olinxia/Olin_BlueStampPortfolio/ceres_data.h

// Generated from Horizons ephemeris data
#include <avr/pgmspace.h>

const uint16_t ceres_num_records = 1218;

const float ceres_ra_deg[] PROGMEM = {
  313.111208f,
  314.306208f,
  315.503042f,
  316.700958f,
  317.899417f,
  319.097958f,
  320.296167f,
  321.493667f,
  322.690042f,
  323.884875f,
  325.077667f,
  326.267833f,
  327.454875f,
  328.638458f,
  329.818250f,
  330.994042f,
  332.165625f,
  333.332792f,
  334.495292f,
  335.652833f,
  336.805000f,
  337.951417f,
  339.091750f,
  340.225833f,
  341.353458f,
  342.474542f,
  343.588917f,
  344.696417f,
  345.796792f,
  346.889708f,
  347.974833f,
  349.051750f,
  350.120167f,
  351.179958f,
  352.230875f,
  353.272750f,
  354.305375f,
  355.328375f,
  356.341417f,
  357.344000f,
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
};

const float ceres_dec_deg[] PROGMEM = {
  -24.848167f,
  -24.542139f,
  -24.229139f,
  -23.909389f,
  -23.583111f,
  -23.250528f,
  -22.911861f,
  -22.567306f,
  -22.217167f,
  -21.861694f,
  -21.501278f,
  -21.136250f,
  -20.767000f,
  -20.393861f,
  -20.017139f,
  -19.637139f,
  -19.254139f,
  -18.868500f,
  -18.480556f,
  -18.090722f,
  -17.699389f,
  -17.307083f,
  -16.914139f,
  -16.520944f,
  -16.127833f,
  -15.735167f,
  -15.343306f,
  -14.952611f,
  -14.563500f,
  -14.176444f,
  -13.791917f,
  -13.410389f,
  -13.032278f,
  -12.657917f,
  -12.287694f,
  -11.921972f,
  -11.561139f,
  -11.205639f,
  -10.855944f,
  -10.512583f,
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
};

const float ceres_dist_au[] PROGMEM = {
  3.798340f,
  3.818357f,
  3.837101f,
  3.854562f,
  3.870736f,
  3.885617f,
  3.899194f,
  3.911454f,
  3.922381f,
  3.931959f,
  3.940177f,
  3.947028f,
  3.952513f,
  3.956640f,
  3.959418f,
  3.960850f,
  3.960938f,
  3.959678f,
  3.957070f,
  3.953110f,
  3.947802f,
  3.941157f,
  3.933192f,
  3.923929f,
  3.913384f,
  3.901570f,
  3.888498f,
  3.874175f,
  3.858610f,
  3.841813f,
  3.823802f,
  3.804603f,
  3.784247f,
  3.762761f,
  3.740169f,
  3.716491f,
  3.691745f,
  3.665948f,
  3.639119f,
  3.611280f,
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
};
