olinxia/Olin_BlueStampPortfolio/eris_data.h

// Generated from Horizons ephemeris data
#include <avr/pgmspace.h>

const uint16_t eris_num_records = 1218;

const float eris_ra_deg[] PROGMEM = {
  26.213125f,
  26.206000f,
  26.200333f,
  26.196208f,
  26.193625f,
  26.192542f,
  26.193000f,
  26.195000f,
  26.198500f,
  26.203542f,
  26.210125f,
  26.218167f,
  26.227667f,
  26.238625f,
  26.250958f,
  26.264667f,
  26.279708f,
  26.296042f,
  26.313583f,
  26.332375f,
  26.352292f,
  26.373292f,
  26.395333f,
  26.418333f,
  26.442250f,
  26.467000f,
  26.492542f,
  26.518792f,
  26.545708f,
  26.573167f,
  26.601208f,
  26.629625f,
  26.658417f,
  26.687500f,
  26.716833f,
  26.746250f,
  26.775792f,
  26.805292f,
  26.834792f,
  26.864125f,
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
};

const float eris_dec_deg[] PROGMEM = {
  -0.710000f,
  -0.704861f,
  -0.699056f,
  -0.692639f,
  -0.685639f,
  -0.678028f,
  -0.669833f,
  -0.661056f,
  -0.651750f,
  -0.641944f,
  -0.631611f,
  -0.620778f,
  -0.609528f,
  -0.597833f,
  -0.585778f,
  -0.573333f,
  -0.560556f,
  -0.547444f,
  -0.534083f,
  -0.520444f,
  -0.506583f,
  -0.492556f,
  -0.478361f,
  -0.464083f,
  -0.449694f,
  -0.435250f,
  -0.420778f,
  -0.406306f,
  -0.391889f,
  -0.377528f,
  -0.363278f,
  -0.349167f,
  -0.335222f,
  -0.321472f,
  -0.307972f,
  -0.294694f,
  -0.281694f,
  -0.269028f,
  -0.256667f,
  -0.244667f,
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
};

const float eris_dist_au[] PROGMEM = {
  95.381709f,
  95.431397f,
  95.481570f,
  95.532081f,
  95.582788f,
  95.633557f,
  95.684253f,
  95.734737f,
  95.784869f,
  95.834505f,
  95.883498f,
  95.931700f,
  95.978974f,
  96.025190f,
  96.070231f,
  96.113983f,
  96.156332f,
  96.197167f,
  96.236376f,
  96.273846f,
  96.309469f,
  96.343144f,
  96.374787f,
  96.404323f,
  96.431687f,
  96.456816f,
  96.479650f,
  96.500131f,
  96.518201f,
  96.533810f,
  96.546912f,
  96.557478f,
  96.565495f,
  96.570955f,
  96.573856f,
  96.574197f,
  96.571980f,
  96.567208f,
  96.559891f,
  96.550041f,
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
};
