olinxia/Olin_BlueStampPortfolio/haumea_data.h

// Generated from Horizons ephemeris data
#include <avr/pgmspace.h>

const uint16_t haumea_num_records = 1218;

const float haumea_ra_deg[] PROGMEM = {
  220.007375f,
  220.044500f,
  220.078958f,
  220.110708f,
  220.139667f,
  220.165750f,
  220.189000f,
  220.209250f,
  220.226500f,
  220.240750f,
  220.251875f,
  220.259917f,
  220.264875f,
  220.266708f,
  220.265500f,
  220.261292f,
  220.254000f,
  220.243750f,
  220.230542f,
  220.214458f,
  220.195500f,
  220.173792f,
  220.149417f,
  220.122458f,
  220.093042f,
  220.061250f,
  220.027167f,
  219.990958f,
  219.952667f,
  219.912500f,
  219.870500f,
  219.826917f,
  219.781833f,
  219.735458f,
  219.687917f,
  219.639333f,
  219.589875f,
  219.539708f,
  219.488958f,
  219.437833f,
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
};

const float haumea_dec_deg[] PROGMEM = {
  13.971028f,
  13.985778f,
  14.002056f,
  14.019750f,
  14.038861f,
  14.059306f,
  14.081028f,
  14.103972f,
  14.128083f,
  14.153278f,
  14.179472f,
  14.206611f,
  14.234583f,
  14.263333f,
  14.292722f,
  14.322694f,
  14.353139f,
  14.384000f,
  14.415194f,
  14.446583f,
  14.478083f,
  14.509611f,
  14.541028f,
  14.572278f,
  14.603222f,
  14.633806f,
  14.663917f,
  14.693500f,
  14.722417f,
  14.750611f,
  14.777972f,
  14.804417f,
  14.829861f,
  14.854250f,
  14.877472f,
  14.899500f,
  14.920278f,
  14.939694f,
  14.957722f,
  14.974306f,
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
};

const float haumea_dist_au[] PROGMEM = {
  50.239072f,
  50.195075f,
  50.150309f,
  50.104900f,
  50.058969f,
  50.012635f,
  49.966013f,
  49.919227f,
  49.872402f,
  49.825668f,
  49.779160f,
  49.733013f,
  49.687360f,
  49.642324f,
  49.598022f,
  49.554566f,
  49.512069f,
  49.470643f,
  49.430402f,
  49.391460f,
  49.353930f,
  49.317921f,
  49.283526f,
  49.250831f,
  49.219912f,
  49.190843f,
  49.163698f,
  49.138546f,
  49.115455f,
  49.094492f,
  49.075714f,
  49.059168f,
  49.044885f,
  49.032888f,
  49.023197f,
  49.015828f,
  49.010793f,
  49.008105f,
  49.007770f,
  49.009789f,
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
};
