olinxia/Olin_BlueStampPortfolio/makemake_data.h

// Generated from Horizons ephemeris data
#include <avr/pgmspace.h>

const uint16_t makemake_num_records = 1218;

const float makemake_ra_deg[] PROGMEM = {
  201.557958f,
  201.575208f,
  201.589583f,
  201.601000f,
  201.609458f,
  201.615000f,
  201.617583f,
  201.617167f,
  201.613792f,
  201.607500f,
  201.598250f,
  201.586125f,
  201.571208f,
  201.553500f,
  201.533125f,
  201.510083f,
  201.484542f,
  201.456542f,
  201.426167f,
  201.393500f,
  201.358708f,
  201.321833f,
  201.283083f,
  201.242583f,
  201.200458f,
  201.156792f,
  201.111792f,
  201.065583f,
  201.018292f,
  200.970042f,
  200.921042f,
  200.871500f,
  200.821500f,
  200.771208f,
  200.720833f,
  200.670500f,
  200.620333f,
  200.570500f,
  200.521167f,
  200.472500f,
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
};

const float makemake_dec_deg[] PROGMEM = {
  20.645111f,
  20.665194f,
  20.686528f,
  20.709000f,
  20.732556f,
  20.757139f,
  20.782639f,
  20.809028f,
  20.836194f,
  20.864056f,
  20.892528f,
  20.921528f,
  20.950889f,
  20.980583f,
  21.010472f,
  21.040472f,
  21.070528f,
  21.100500f,
  21.130306f,
  21.159861f,
  21.189028f,
  21.217722f,
  21.245861f,
  21.273333f,
  21.300056f,
  21.325972f,
  21.350972f,
  21.375000f,
  21.397972f,
  21.419778f,
  21.440361f,
  21.459667f,
  21.477611f,
  21.494167f,
  21.509250f,
  21.522833f,
  21.534889f,
  21.545361f,
  21.554222f,
  21.561444f,
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
};

const float makemake_dist_au[] PROGMEM = {
  52.703263f,
  52.656978f,
  52.610804f,
  52.564873f,
  52.519311f,
  52.474236f,
  52.429767f,
  52.386028f,
  52.343142f,
  52.301235f,
  52.260433f,
  52.220860f,
  52.182629f,
  52.145844f,
  52.110599f,
  52.076984f,
  52.045089f,
  52.015003f,
  51.986812f,
  51.960600f,
  51.936448f,
  51.914423f,
  51.894581f,
  51.876964f,
  51.861610f,
  51.848552f,
  51.837823f,
  51.829453f,
  51.823465f,
  51.819879f,
  51.818705f,
  51.819938f,
  51.823560f,
  51.829546f,
  51.837871f,
  51.848505f,
  51.861419f,
  51.876577f,
  51.893942f,
  51.913467f,
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
};
