olinxia/Olin_BlueStampPortfolio/(commit log)

2025-06-16 Update index.md
    added arduino pricing
2025-06-16 Update index.md
    added link for amazon for arduino mega
